m24842/TrackingCamera/media/images/Render1.png

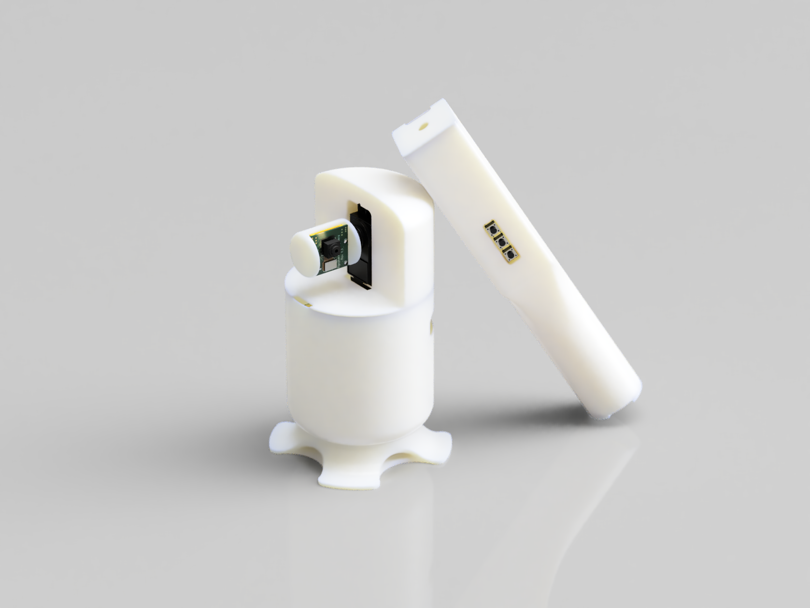
media/images/Render1.png
