m24842/TrackingCamera/media/images/Render2.png

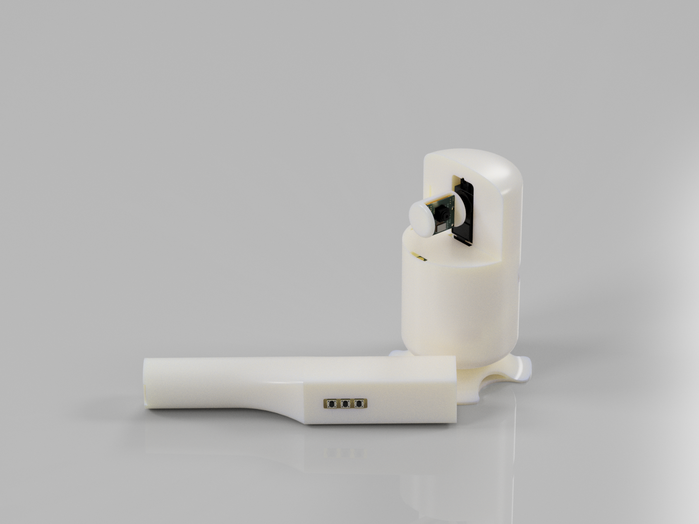
media/images/Render2.png
