m24842/TrackingCamera/media/models/TrackingCamera_Base_Plate.stl

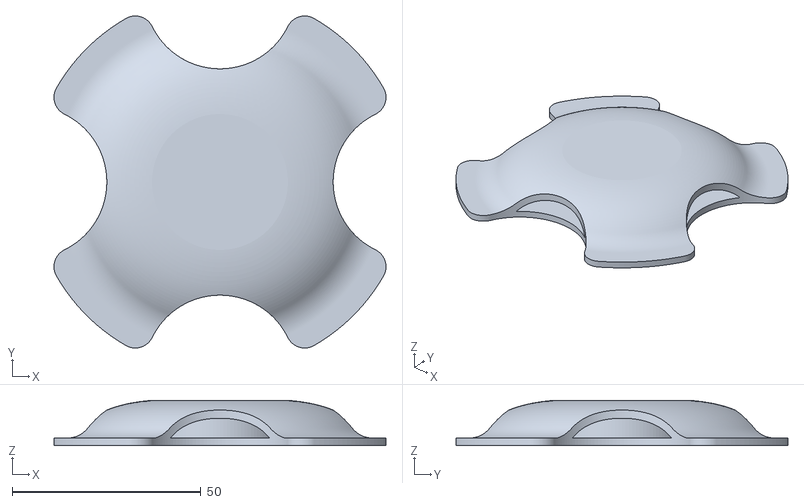
[picture p6: CAD file, 2025-04-13]
media/models/TrackingCamera_Base_Plate.stl
88.0 x 88.0 x 12.0
