m24842/TrackingCamera/media/models/Remote_Battery_Cap.stl

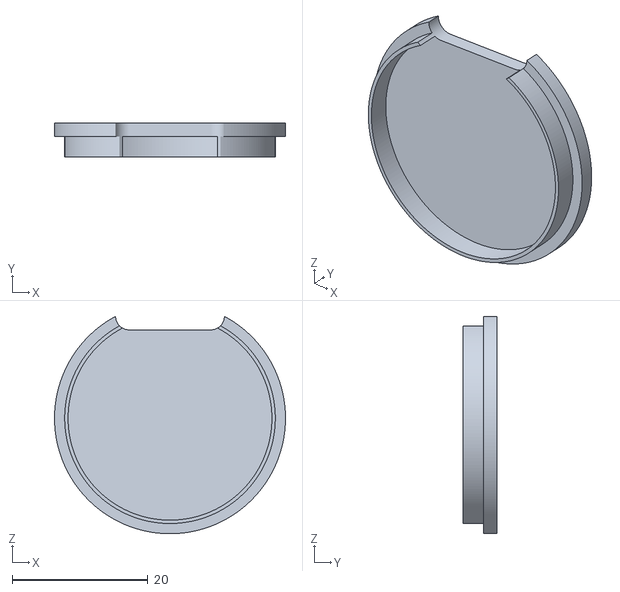
[picture p7: CAD file, 2025-04-13]
media/models/Remote_Battery_Cap.stl
34.0 x 5.00 x 32.0
