m24842/TrackingCamera/media/models/TrackingCamera_Body.stl

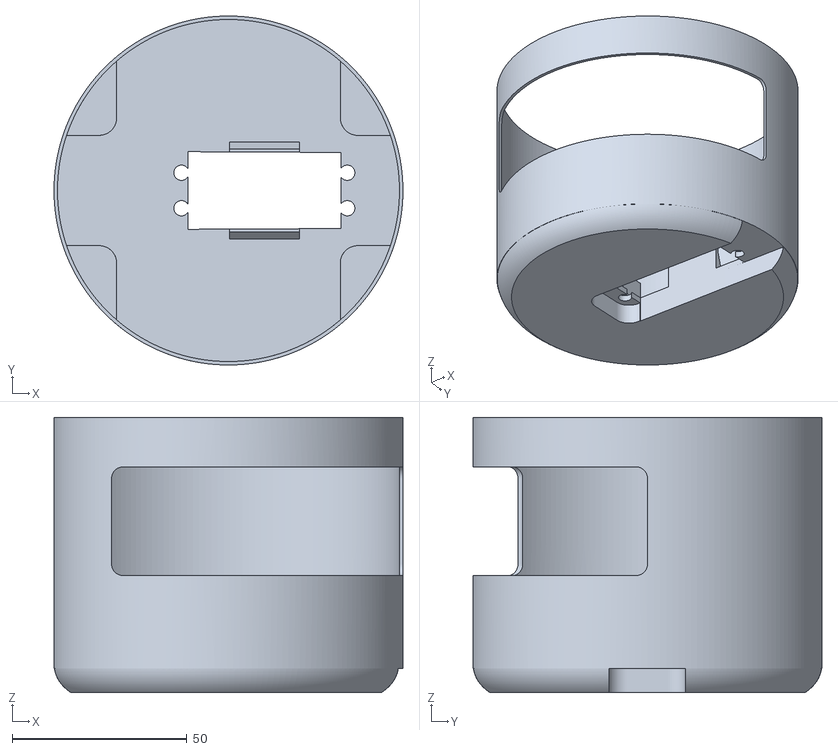
[picture p8: CAD file, 2025-04-13]
media/models/TrackingCamera_Body.stl
100.0 x 100.0 x 78.9
