m24842/TrackingCamera/media/models/Remote_Laser_Cap.stl

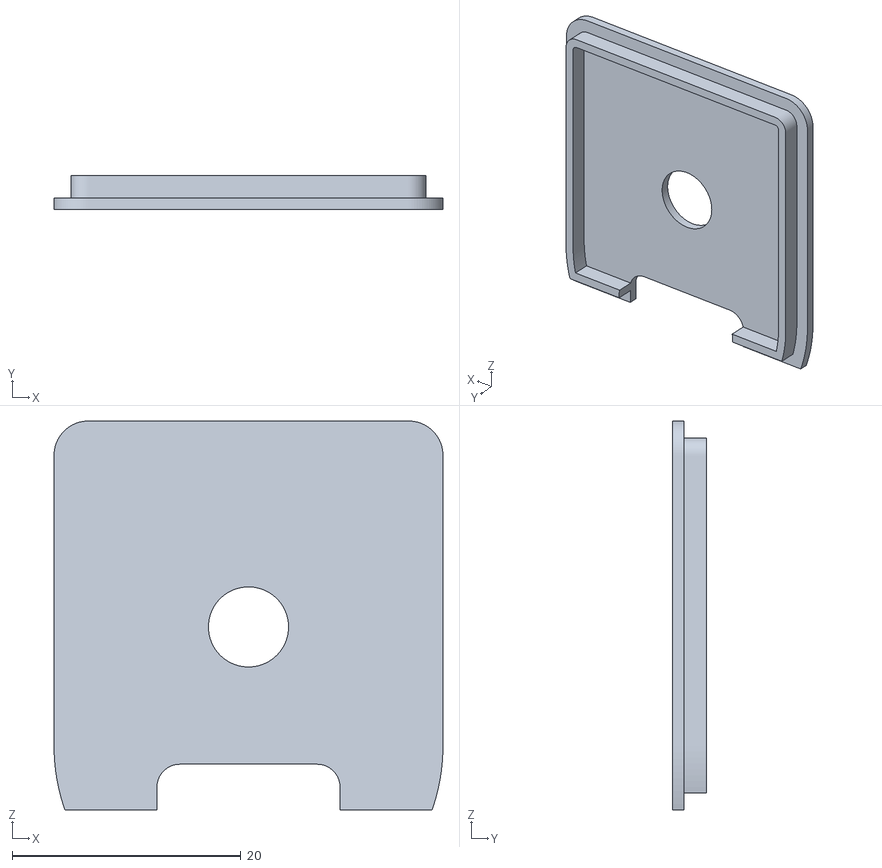
[picture p9: CAD file, 2025-04-13]
media/models/Remote_Laser_Cap.stl
34.0 x 3.00 x 34.0
