m24842/TrackingCamera/media/models/TrackingCamera_Y_Axis_Servo_Mount.stl

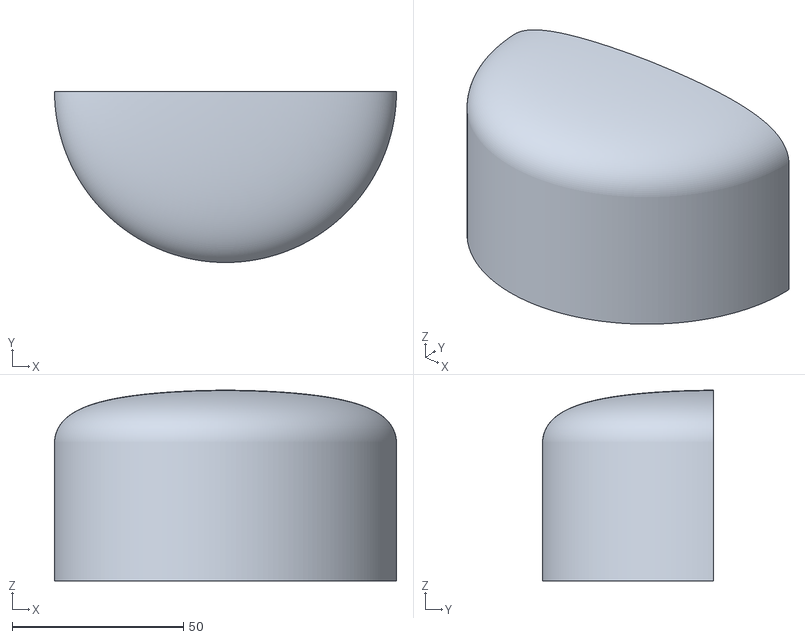
[picture p10: CAD file, 2025-04-13]
media/models/TrackingCamera_Y_Axis_Servo_Mount.stl
100.0 x 50.0 x 55.8
