m24842/TrackingCamera/media/models/TrackingCamera_Body_Cap.stl

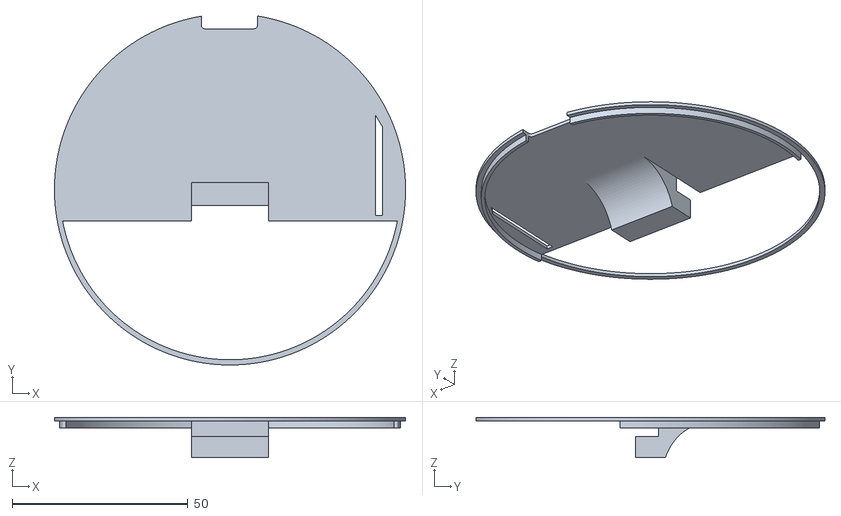
[picture p11: CAD file, 2025-04-13]
media/models/TrackingCamera_Body_Cap.stl
100.0 x 99.4 x 11.5
