m24842/TrackingCamera/media/models/Remote_Body.stl

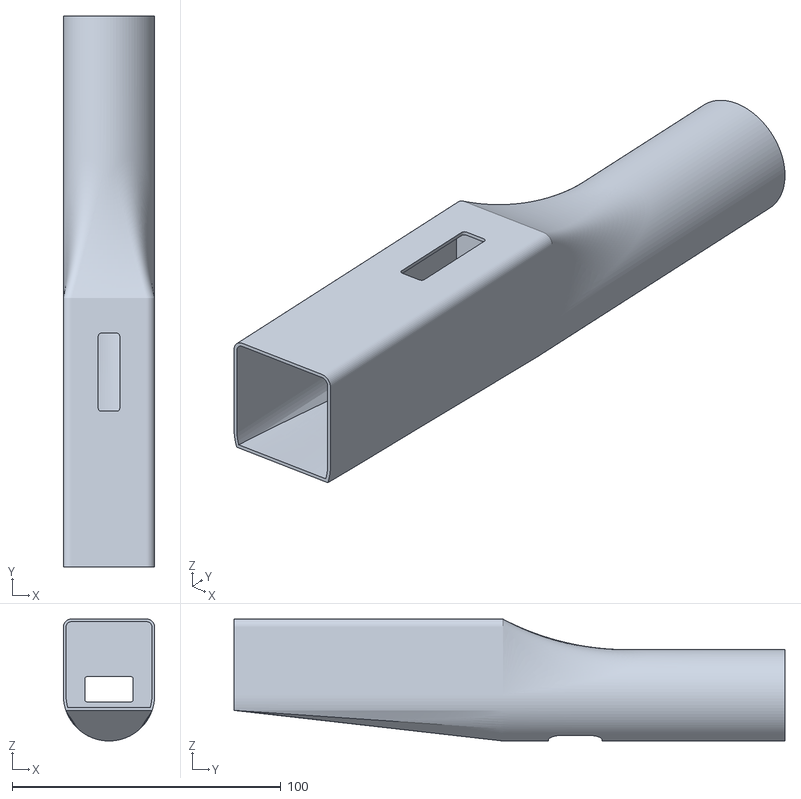
[picture p12: CAD file, 2025-04-13]
media/models/Remote_Body.stl
34.0 x 205.0 x 45.4
