m24842/TrackingCamera/media/models/TrackingCamera_Camera_Mount.stl

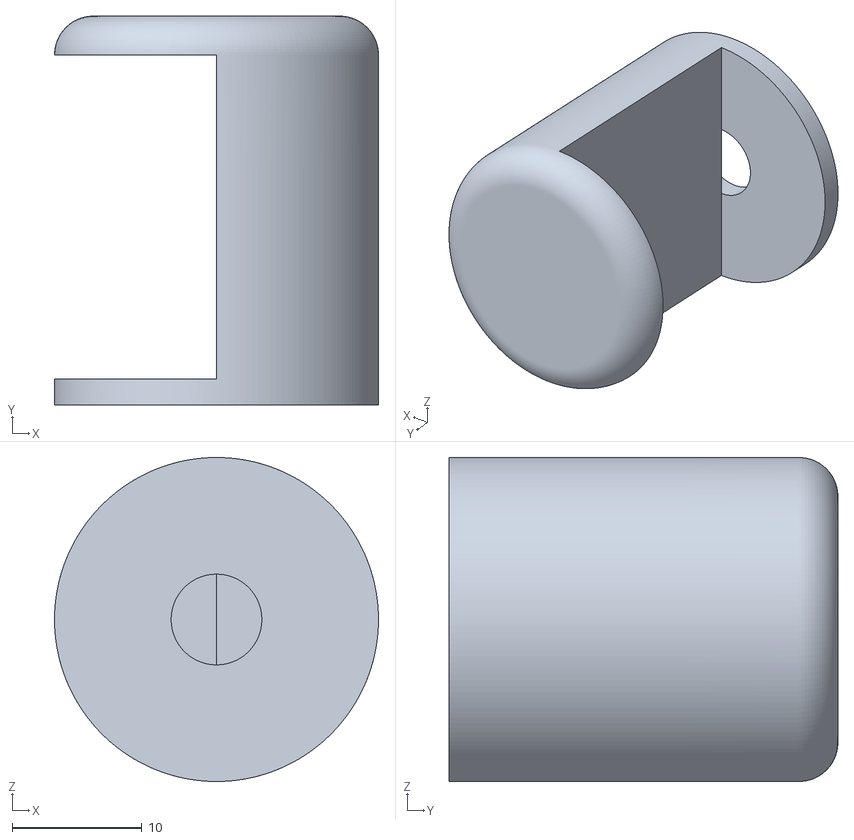
[picture p13: CAD file, 2025-04-13]
media/models/TrackingCamera_Camera_Mount.stl
25.0 x 30.0 x 25.0
