m24842/TrackingCamera/src/Remote/main.cpp

#include "mbed.h"

DigitalIn trackToggle(p25); // Button to start/stop tracking
DigitalIn changeTarget(p23); // Button to change target ID

DigitalIn laserButton(p24); // Button to activate laser
DigitalOut laser(p20); // Laser power

UnbufferedSerial bluetooth(p9, p10); // Bluetooth module to communicate with tracking camera

bool track = false; // Initial state

/**
 * Send a command to the tracking camera to start or stop tracking.
 */
void sendTrack() {
    track = !track;
    if (track) {
        printf("START\n");
        char command[20];
        snprintf(command, sizeof(command), "START\n");
        bluetooth.write(command, strlen(command));
    } else {
        printf("STOP\n");
        char command[20];
        snprintf(command, sizeof(command), "STOP\n");
        bluetooth.write(command, strlen(command));
    }
    while (trackToggle) wait_us(1e4);
}

/**
 * Send a command to the tracking camera to increment the target ID.
 */
void sendChangeTarget() {
    printf("CHANGE\n");
    char command[20];
    snprintf(command, sizeof(command), "CHANGE\n");
    bluetooth.write(command, strlen(command));
    while (changeTarget) wait_us(1e4);
}

/**
 * Control laser activation.
 */
void handleLaser() {
    laser = laserButton;
}

/**
 * Initialize the Bluetooth module for communication with tracking camera.
 */
void initBluetooth() {
    bluetooth.baud(9600);
    printf("Bluetooth initialized\n");
}

int main() {
    initBluetooth();

    while (1) {
        handleLaser();
        if (trackToggle) sendTrack();
        if (changeTarget) sendChangeTarget();
    }
}
