m24842/TrackingCamera/src/Camera/config.py

ACCELERATOR_PORT = "/dev/ttyGS0"
BLUETOOTH_PORT = "/dev/rfcomm0"
BLUETOOTH_MAC_ADDRESS = "00:14:03:05:0D:08"
FRAME_BUFFER_PORT = "/dev/fb0"
FRAME_SHAPE = (1920, 1080) # Set in config.txt
MOTOR_X_RANGE = (45, 135)
MOTOR_Y_RANGE = (70, 110)
MOTOR_V_MAX = 4
MOVEMENT_ORDER = 2
MOVEMENT_SCALE = 1.5
MOTOR_RESOLUTION = 1e-1
HAND_SHOULDER_HIP_ANGLE = 70
